Xinyuan-LilyGO/TTCar_3D_Model/README.md

# TTCar_3D_Model

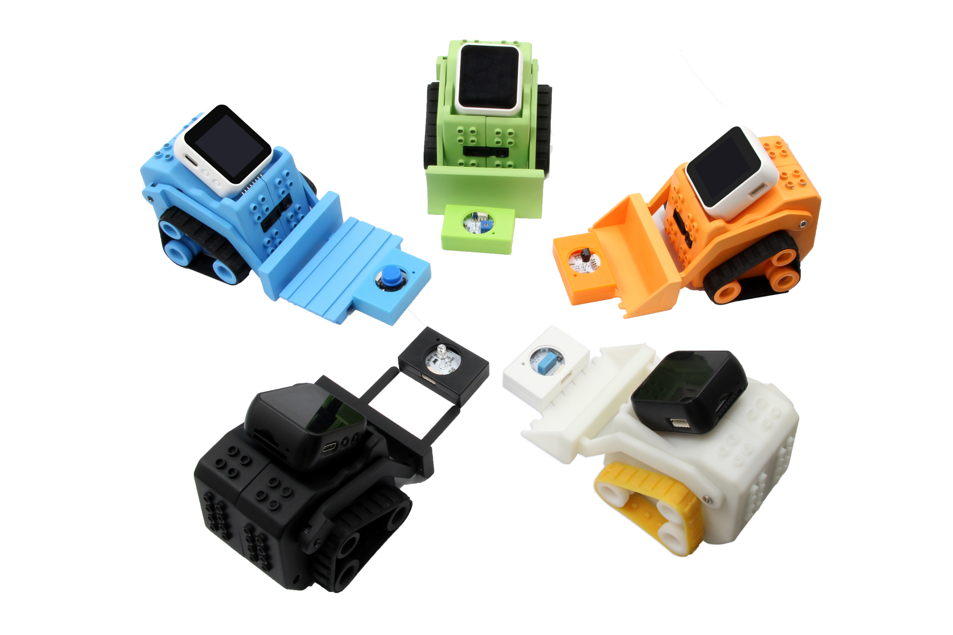
[picture p1: image/image1.jpg]
