Xinyuan-LilyGO/TTCar_3D_Model/(list of files, cad)

Other CAD files:
3d_file/T-WATCH TTcar.stl
